DrLex0/print3d-double-edged-razorblade-scraper/DE-Razorblade-cap.stl

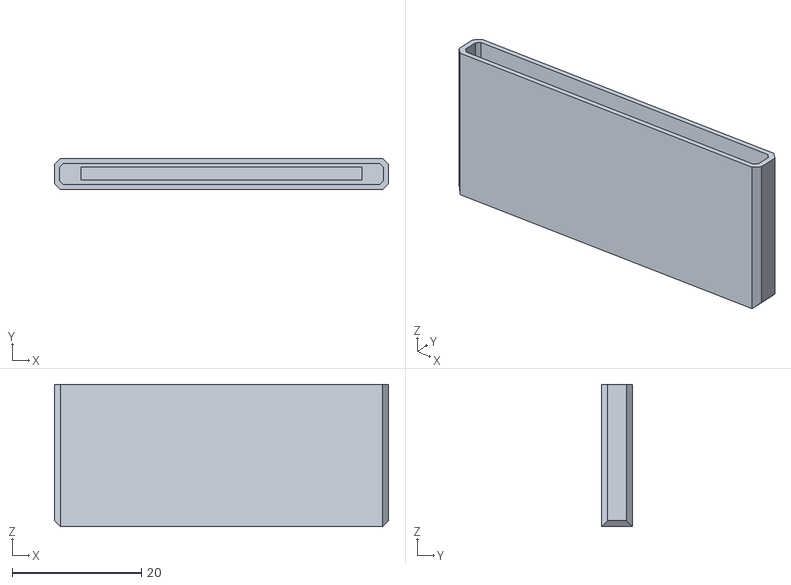
[picture p5: CAD file, 2020-10-10]
DE-Razorblade-cap.stl
51.7 x 4.75 x 22.0
