DrLex0/print3d-double-edged-razorblade-scraper/DE-Razorblade-handle_v3.stl

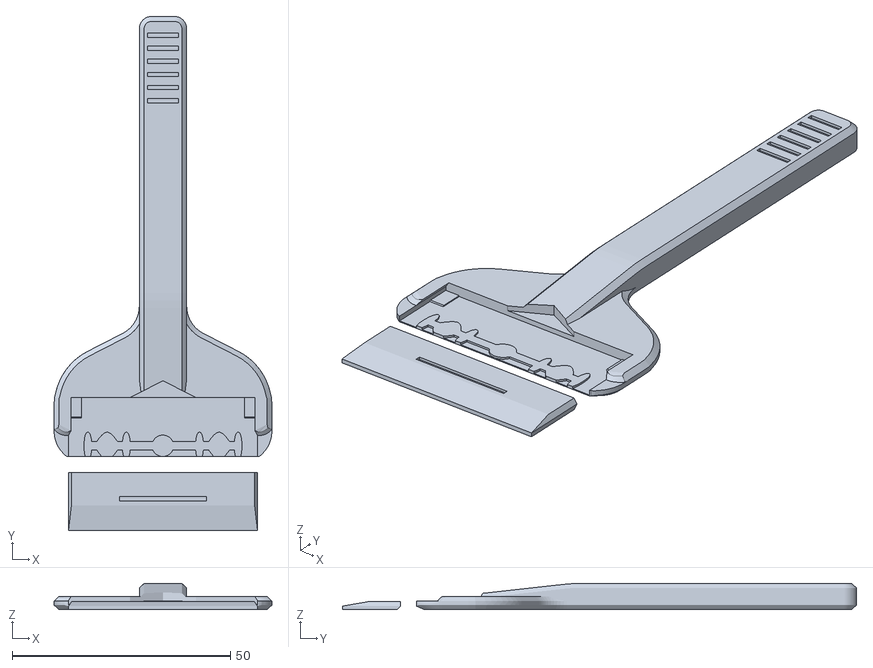
[picture p6: CAD file, 2020-10-10]
DE-Razorblade-handle_v3.stl
49.9 x 117.8 x 6.00
