DrLex0/print3d-double-edged-razorblade-scraper/DE-Razorblade-handle_v2.stl

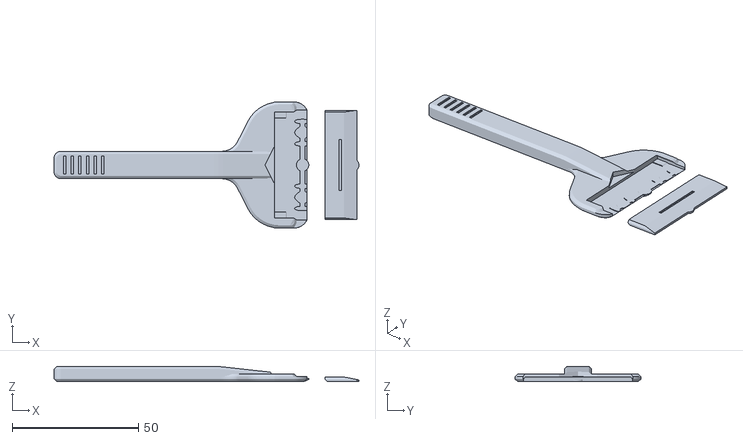
[picture p7: CAD file, 2020-10-10, an earlier design]
DE-Razorblade-handle_v2.stl
120.7 x 49.9 x 6.00
